solegstar/IgroSpec/(list of files, drawings)

Other design files:
pcad/Rev.A/IgroSpec.pcb
pcad/Rev.B/IgroSpec_revB.pcb
