solegstar/IgroSpec/firmware/src/profi/rtl/igrospec.vhd

-- --------------------------------------------------------------------
-- IgroSpec rev.B firmware
-- v1.0
-- (c) 2019 Andy Karpov
-- (c) 2022 Oleh Starychenko
-- --------------------------------------------------------------------

library IEEE;
use IEEE.std_logic_1164.all;
use IEEE.numeric_std.all;

entity igrospec is
	port(
		-- Clock
		CLK28				: in std_logic;
		CLK24 				: in std_logic;

		-- CPU signals
		CLK_CPU			: out std_logic := '1';
		N_RESET			: in std_logic;
		N_INT				: out std_logic := '1';
		N_RD				: in std_logic;
		N_WR				: in std_logic;
		N_IORQ_Z80		: in std_logic;
		N_MREQ			: in std_logic;
		N_M1				: in std_logic;
		A					: in std_logic_vector(15 downto 0);
		D 					: inout std_logic_vector(7 downto 0) := "ZZZZZZZZ";
		
		-- Unused CPU signals
		N_BUSREQ 		: in std_logic;
		N_BUSACK 		: in std_logic;
		N_WAIT 			: in std_logic;
		N_HALT			: in std_logic;
		N_NMI 			: out std_logic := 'Z';
		N_RFSH			: in std_logic;		

		-- RAM 
		MA 				: out std_logic_vector(18 downto 0);
		MD 				: inout std_logic_vector(7 downto 0) := "ZZZZZZZZ";
		N_MRD1			: out std_logic := '1';
		N_MWR1			: out std_logic := '1';
		N_MRD2			: out std_logic := '1';
		N_MWR2			: out std_logic := '1';
		
		-- VRAM 
		VA 				: out std_logic_vector(14 downto 0) := "000000000000000";
		VD 				: inout std_logic_vector(7 downto 0) := "ZZZZZZZZ";
		N_VRAMWR			: out std_logic := '1';

		-- ROM
		N_ROMCS			: out std_logic := '1';
		N_ROMWR			: out std_logic := '1';
		ROM_A				: out std_logic_vector (18 downto 14);
		
		-- ZX BUS signals
		BUS_N_IORQGE 	: in std_logic := '0';
		BUS_N_ROMCS 	: out std_logic := '1';
		CLK_ZXBUS		: out std_logic := '1';
		BUS_N_RDR	 	: in std_logic := '1';
		BUS_RS 			: in std_logic := '0';
		BUS_BLK		 	: in std_logic := '0';
		BUS_N_DOS	 	: out std_logic := '1';
		BUS_F			 	: out std_logic := '0';
		BUS_N_IODOS	 	: out std_logic := '1';

		-- Video
		VIDEO_CSYNC    : out std_logic;
		VIDEO_R       	: out std_logic_vector(2 downto 0) := "000";
		VIDEO_G       	: out std_logic_vector(2 downto 0) := "000";
		VIDEO_B       	: out std_logic_vector(2 downto 0) := "000";

		-- Interfaces 
		TAPE_IN 			: in std_logic;
		TAPE_OUT			: out std_logic := '1';
		BEEPER			: out std_logic := '1';

		-- AY
		CLK_AY			: out std_logic;
		AY_BC1			: out std_logic;
		AY_BDIR			: out std_logic;

		-- SD card
		SD_CLK 			: out std_logic := '0';
		SD_DI 			: out std_logic;
		SD_DO 			: in std_logic;
		SD_N_CS 			: out std_logic := '1';
		CF_N_CS 			: out std_logic := '1';
		
		-- Keyboard
		KB					: in std_logic_vector(4 downto 0) := "11111";
		-- TODO: extra signals KB 7 downto 5
		
		-- Other in signals
		TURBO_BTN		: in std_logic := '0';
		SPECIAL			: in std_logic := '0';
		IO8 				: in std_logic := '0';		
		IO11 				: in std_logic := '0';		
		IO12 				: in std_logic := '0';		
		IO15 				: in std_logic := '0';
		IO16 				: in std_logic := '0';		
		IO19 				: in std_logic := '0';
		IO21				: in std_logic := '0';				
		IO24 				: in std_logic := '0';		
		IO26 				: in std_logic := '0';
		IO27 				: in std_logic := '0';
		IO64 				: in std_logic := '0';
		IOCLR				: in std_logic := '0';
		IOE				: in std_logic;
		MAPCOND 			: out std_logic;
		NMI_BTN			: in std_logic := '1'

	);
end igrospec;

architecture rtl of igrospec is


	signal CLK 			: std_logic := '0';
	
	signal N_IORQ		: std_logic := '1';		
	
	signal clk_div2 	: std_logic := '0';
	signal clk_div4 	: std_logic := '0';
	signal clk_div8 	: std_logic := '0';
	signal clk_div16	: std_logic := '0';
	
	signal clkcpu 		: std_logic := '1';	

	signal attr_r   	: std_logic_vector(7 downto 0);
	signal vid_a 		: std_logic_vector(13 downto 0);
	signal pFF_CS		: std_logic := '0';

	signal cs_fe 		: std_logic := '0';
	signal border_attr: std_logic_vector(7 downto 0) := x"00";
	signal pal_attr	: std_logic_vector(7 downto 0) := x"00";
	signal cs_7e 		: std_logic := '0';
	signal GX0	 		: std_logic := '1';

	signal port_7ffd	: std_logic_vector(7 downto 0) := (others => '0'); 
	-- CMR0 port:
	-- D0-D2 - RAM seg A0,A1,A2 (column access)
	-- D3 - POLEK. Video page.
						-- 80DS=0: 0 - seg 05, 1 - seg 07 
						-- 80DS=1: 0 - pixels seg 04, attributes seg 38
						--         1 - pixels seg 06, attributes seg 3A
	-- D4 - ROM14. 
						-- CPM=0: 0 - spectrum 128, 1 - spectrum 48
						-- CPM=1: Ext device modifier for CP/M mode
	-- D5 - BLOCK. Block port CMR0 (WOROM=0)
	-- D6,D7 - unused
	signal rom14 		: std_logic := '0';	
																	  
	signal port_dffd 	: std_logic_vector(7 downto 0) := (others => '0');
	-- CMR1 port:
	-- D0-D2 - RAM seg A3,A4,A5 (row access)
	-- D3 - SCO. Window position for segments:
						-- 0 - window 1 (#C000 - #FFFF)
						-- 1 - window 2 (#4000 - #7FFF)
	-- D4 - WOROM. 1 = disable CMR0 port lock, also disable ROM and switch RAM seg 00 instead of it
	-- D5 - CPM. 1  = block controller from TR-DOS ROM and enables ports to access from RAM (ROM14=0)
						-- also when ROM14=1 - mod. access to extended devices in CP/M mode
	-- D6 - SCR. CPU memory instead of seg 02, also CMR0 D3 must be 1 (#8000 - #BFFF)
	-- D7 - 80DS. 0 - Spectrum video mode (seg 05)
				  -- 1 - Profi video mode (seg 06, 3A, 04, 38)
																	  
	signal ram_ext 	: std_logic_vector(2 downto 0) := "000";
	signal ram_do 		: std_logic_vector(7 downto 0);
	signal ram_oe_n 	: std_logic := '1';
	
	signal rom_oe_n 	: std_logic := '1';
	
	signal mem_adr 	: std_logic_vector(19 downto 0);
	
	signal N_MRD 		: std_logic;
	signal N_MWR 		: std_logic;
	
	signal fd_port 	: std_logic := '1';
	signal fd_sel 		: std_logic;
	
	signal turbo_mode	: std_logic;
	
	-- Port selectors
	signal selector	: std_logic_vector(3 downto 0);
	signal cs_7ffd 	: std_logic := '0';
	signal cs_1ffd 	: std_logic := '0';
	signal cs_dffd 	: std_logic := '0';
	signal cs_fffd 	: std_logic := '0';
																	  
	signal ay_port		: std_logic := '0';
	signal bdir 		: std_logic;
	signal bc1 			: std_logic;
		
	signal vbus_mode  : std_logic := '0';
	
	signal sound_out 	: std_logic := '0';
	signal mic 			: std_logic := '0';
	
	signal zc_do_bus	: std_logic_vector(7 downto 0);
	signal zc_wr 		: std_logic :='0';
	signal zc_rd		: std_logic :='0';
	signal zc_sd_cs_n	: std_logic;
	signal zc_sd_di	: std_logic;
	signal zc_sd_clk	: std_logic;
	
	signal vid_rd 		: std_logic;
	
	signal trdos		: std_logic :='1';
	signal IORQGE_ROM	: std_logic :='1';
	
	-- UART 
	signal uart_oe_n		: std_logic := '1';
	signal uart_do_bus	: std_logic_vector(7 downto 0);
	
	-- profi special signals
	signal cpm 			: std_logic := '0';
	signal worom 		: std_logic := '0';
	signal ds80 		: std_logic := '0';
	signal scr 			: std_logic := '0';
	signal sco 			: std_logic := '0';
	signal onoff 		: std_logic := '1'; -- disable CMR1 (port_dffd)	

begin

	 -- main clock selector
	 U0: entity work.clk_mux
	 port map(
		data0 => CLK28,
		data1 => CLK24,
		sel => ds80,
		result => CLK
	 );

	-- memory manager
	U1: entity work.memory 
	port map ( 
		CLK2X => CLK,
		CLKX => clk_div2,
		CLK_CPU => clkcpu,
		--TURBO => turbo,
		BUS_N_ROMCS => BUS_N_RDR,
		
		-- cpu signals
		A => A,
		D => D,
		N_MREQ => N_MREQ,
		N_IORQ => N_IORQ,
		N_WR => N_WR,
		N_RD => N_RD,
		N_M1 => N_M1,

		-- ram 
		MA => mem_adr,
		MD => MD,
		N_MRD => N_MRD,
		N_MWR => N_MWR,
		
		-- ram out to cpu
		DO => ram_do,
		N_OE => ram_oe_n,
		
		-- ram pages
		RAM_BANK => port_7ffd(2 downto 0),
		RAM_EXT => ram_ext, -- seg A3 - seg A5

		-- video
		VA => vid_a,
		VID_PAGE => port_7ffd(3), -- seg A0 - seg A2
		DS80 => ds80,
		CPM => cpm,
		SCO => sco,
		SCR => scr,
		WOROM => worom,

		-- video bus control signals
		VBUS_MODE_O => vbus_mode, -- video bus mode: 0 - ram, 1 - vram
		VID_RD_O => vid_rd -- read attribute or pixel	
	);
		
	-- Z-Controller
	U2: entity work.zcontroller 
	port map(
		RESET => not(N_RESET),
		CLK => clk_div4,
		A => A(5),
		DI => D,
		DO => zc_do_bus,
		RD => zc_rd,
		WR => zc_wr,
		SDDET => '0',
		SDPROT => '0',
		CS_n => zc_sd_cs_n,
		SCLK => zc_sd_clk,
		MOSI => zc_sd_di,
		MISO => SD_DO
	);
	
-- video controller
	U3: entity work.video 
	port map (
		CLK => clk_div2, -- 14
		CLK2x => CLK, -- 28
		ENA => clk_div4, -- 7
		
		N_RESET => N_RESET,
		
		BORDER => border_attr,
		PAL_ADR => pal_attr,
		DI => MD,
		TURBO => turbo_mode,
		INTA => N_IORQ or N_M1,
		INT => N_INT,
		ATTR_O => attr_r, 
		A => vid_a,
		pFF_CS => pFF_CS,
		
		DS80 => ds80,
		
		CS7E => cs_7e,
		BUS_A => A (15 downto 8),
		BUS_WR_N => N_WR,
		GX0 => GX0,
		
		VA => VA,
		VD => VD,
		N_VRAMWR => N_VRAMWR,
		
		VIDEO_R => VIDEO_R,
		VIDEO_G => VIDEO_G,
		VIDEO_B => VIDEO_B,
		
		HSYNC => open,
		VSYNC => open,
		CSYNC => VIDEO_CSYNC,

		VBUS_MODE => vbus_mode,
		VID_RD => vid_rd
	);
	
	U4: entity work.ROM
	port map (
		CLK				=> CLK,
		ADR				=> A(15 downto 0),
		DATA				=> D(7 downto 0),
		nRESET			=> N_RESET,
		nWR				=> N_WR,
		nRD				=> N_RD,
		nIORQ				=> N_IORQ_Z80,
		nMREQ				=> N_MREQ,
		nDOS				=> trdos,
		ROM14				=> rom14,
		nROM_EN			=> worom,
		rom_a(18 downto 14)	=> ROM_A(18 downto 14),
		rom_we			=> N_ROMWR,
		rom_oe			=> rom_oe_n,
		IORQGE_ROM		=> IORQGE_ROM
	);
	
	-- clocks
	process (CLK)
	begin 
		if (CLK'event and CLK = '1') then 
			clk_div2 <= not(clk_div2);
		end if;
	end process;
	
	process (clk_div2)
	begin 
		if (clk_div2'event and clk_div2 = '1') then 
			clk_div4 <= not(clk_div4);
		end if;
	end process;
	
	process (clk_div4)
	begin 
		if (clk_div4'event and clk_div4 = '1') then 
			clk_div8 <= not(clk_div8);
		end if;
	end process;

	process (clk_div8)
	begin 
		if (clk_div8'event and clk_div8 = '1') then 
			clk_div16 <= not(clk_div16);
		end if;
	end process;
	
	-- Sync Z80 with CLK
	process (CLK)
	begin
		if CLK'event and CLK = '1' then
			N_IORQ <= N_IORQ_Z80 or BUS_N_IORQGE;
			turbo_mode <= not TURBO_BTN;
		end if;
	end process;

	-- ROM
	N_ROMCS <= rom_oe_n;

	--RAM
	MA <= mem_adr(18 downto 0);
	
	N_MRD1 <= '0' when N_MRD = '0' and mem_adr(19) = '0' else '1';  
	N_MWR1 <= '0' when N_MWR = '0' and mem_adr(19) = '0' else '1';  
	N_MRD2 <= '0' when N_MRD = '0' and mem_adr(19) = '1' else '1';  
	N_MWR2 <= '0' when N_MWR = '0' and mem_adr(19) = '1' else '1';
	
	-- #FD port correction
	-- IN A, (#FD) - read a value from a hardware port 
	-- OUT (#FD), A - writes the value of the second operand into the port given by the first operand.
	 fd_sel <= '0' when D(7 downto 4) = "1101" and D(2 downto 0) = "011" else '1'; -- IN, OUT Z80 Command Latch

	 process(fd_sel, N_M1, N_RESET)
	 begin
			if N_RESET='0' then
				  fd_port <= 	'1';
			elsif rising_edge(N_M1) then 
				  fd_port <= fd_sel;
			end if;
	 end process;

	-- CPU clk selector

	process (CLK, clk_div2, clk_div4, clk_div8, clkcpu)
	begin
		if CLK'event and CLK = '1' then
			if clk_div2 = '1' and turbo_mode = '0' then
				clkcpu <= clk_div4;
			elsif clk_div2 = '0' and clk_div4 = '1' and turbo_mode = '1' then
				clkcpu <= clk_div8;
			end if;
		end if;
	end process;

--clkcpu <= clk_div8;

	--ZX-BUS Signals
	BUS_F <= clk_div2;
	BUS_N_IODOS <= not cpm;
	BUS_N_DOS <= trdos;
	BUS_N_ROMCS <= rom_oe_n;
	CLK_CPU <= clkcpu;
	CLK_ZXBUS <= clk_div2;
	CLK_AY	<= clk_div16;

	-- CF Card
	CF_N_CS <= '0' when A(5 downto 3) = "101" and A(1 downto 0) = "11" and N_IORQ = '0' and N_M1 = '1' and BUS_N_IORQGE = '0' else '1';

	-- SD card
	-- z-controller 
	zc_wr <= '1' when (N_IORQ = '0' and N_M1 = '1' and N_WR = '0' and A(7 downto 6) = "01" and A(4 downto 0) = "10111") else '0';
	zc_rd <= '1' when (N_IORQ = '0' and N_M1 = '1' and N_RD = '0' and A(7 downto 6) = "01" and A(4 downto 0) = "10111") else '0';
	SD_N_CS <= zc_sd_cs_n;
	SD_CLK <= zc_sd_clk;
	SD_DI <= zc_sd_di;

	-- AY signals
	AY_BDIR	<= '1' when (N_M1 = '1' and N_IORQ = '0' and N_WR = '0' and A(15) = '1' and A(1) = '0') and BUS_N_IORQGE = '0' else '0';
	AY_BC1	<= '1' when (N_M1 = '1' and N_IORQ = '0' and A(15) = '1' and A(14) = '1' and A(1) = '0') and BUS_N_IORQGE = '0' else '0';
	
	-- Tape Out bit
	TAPE_OUT <= border_attr(3);
	-- beeper
	BEEPER <= border_attr(4);
	
	-- NMI button
	N_NMI <= NMI_BTN;
	
	-- Mapcond LED control
--	MAPCOND <= '1';
	MAPCOND <= not zc_sd_cs_n;

	rom14 <= port_7ffd(4); -- rom bank
	cpm <= port_dffd(5); -- 1 - блокирует работу контроллера из ПЗУ TR-DOS и включает порты на доступ из ОЗУ (ROM14=0); При ROM14=1 - мод. доступ к расширен. периферии
	worom <= port_dffd(4); -- 1 - отключает блокировку порта 7ffd и выключает ПЗУ, помещая на его место ОЗУ из seg 00
	ds80 <= port_dffd(7); -- 0 = seg05 spectrum bitmap, 1 = profi bitmap seg06 & seg 3a & seg 04 & seg 38
	scr <= port_dffd(6); -- памяти CPU на место seg 02, при этом бит D3 CMR0 должен быть в 1 (#8000-#BFFF)
	sco <= port_dffd(3); -- Выбор положения окна проецирования сегментов:
								-- 0 - окно номер 1 (#C000-#FFFF)
								-- 1 - окно номер 2 (#4000-#7FFF)
	
	ram_ext <= port_dffd(2 downto 0);
	
	cs_fe <= '1' when N_IORQ = '0' and A(0) = '0' else '0';
	cs_dffd <= '1' when N_IORQ = '0' and N_M1 = '1' and A = X"DFFD" and fd_port = '1' else '0';
	cs_7ffd <= '1' when N_IORQ = '0' and N_M1 = '1' and A(15) = '0' and A(1) = '0' else '0';
	
	-- ports, write by CPU
	process( CLK, N_RESET, A, D, port_7ffd, N_M1, N_MREQ )
	begin
		if N_RESET = '0' then
			port_dffd <= (others => '0');
			port_7ffd <= (others => '0');
			trdos <= '0'; -- 1 - boot into service rom, 0 - boot into 128 menu
		elsif CLK'event and CLK = '1' then 

				-- port #DFFD (profi ram ext)
				if cs_dffd = '1' and N_WR = '0' then
					port_dffd <= D;
				end if;
				
				-- port #7FFD 
				if cs_7ffd = '1' and N_WR = '0' and IORQGE_ROM = '0' and (port_7ffd(5) = '0' or port_dffd(4)='1') then -- short decoding #FD
					port_7ffd <= D;
				end if;

				-- port #FE
				if cs_fe = '1' and N_WR = '0' then
					border_attr <= D; -- border attr
				end if;

				-- trdos flag
				if N_M1 = '0' and N_MREQ = '0' and A(15 downto 8) = X"3D" and rom14 = '1' then 
					trdos <= '0';
				elsif ((N_M1 = '0' and N_MREQ = '0' and A(15 downto 14) /= "00")) then 
					trdos <= '1'; 
				end if;
				
		end if;
	end process;
	
	-- порты #7e - пишутся по фронту /wr
	pal_attr <= D when cs_fe = '1' and (N_WR'event and N_WR = '1');
	cs_7e <= '1' when cs_fe = '1' and A(7) = '0' else '0';
	
	-- read ports by CPU
process (selector, ram_do, port_dffd, port_7ffd, zc_do_bus, GX0, TAPE_IN, KB, attr_r)
	begin
		case selector is
			when x"0" => D <= ram_do; 		-- #memory
			when x"1" => D <= port_dffd;	-- #DFFD read
			when x"2" => D <= port_7ffd;	-- #7FFD read
			when x"3" => D <= zc_do_bus;	-- Z-controller
			when x"4" => D <= GX0 & TAPE_IN & '1' & KB(4 downto 0);	-- #FE - keyboard
			when x"5" => D <= attr_r;		-- #FF - attributes
			when others => D <= "ZZZZZZZZ";
		end case;
	end process;

selector <=
	x"0" when ram_oe_n = '0' else -- #memory
	x"1" when cs_dffd = '1' and N_RD = '0' and BUS_N_IORQGE = '0' else -- #DFFD read
	x"2" when cs_7ffd = '1' and A = X"7FFD" and N_RD = '0' and BUS_N_IORQGE = '0' else  -- #7FFD read
	x"3" when zc_rd = '1' and BUS_N_IORQGE = '0' else -- Z-controller
	x"4" when cs_fe = '1' and N_RD = '0' and BUS_N_IORQGE = '0' else -- #FE - keyboard
	x"5" when pFF_CS = '0' and N_IORQ = '0' and N_RD = '0' and A(7 downto 0) = x"FF" and trdos = '1' and cpm = '0' and DS80 = '0' and BUS_N_IORQGE = '0' else -- #FF - attributes (timex port never set)
	(others => '1');

end;
