solegstar/IgroSpec/(commit log)

2021-06-06 Added "CF BUSY" LED and KX generator
    [IgroSpec.SCH, IgroSpec_revB.pcb]
2021-06-06 Corrected BOM and album
    [IgroSpec_BOM.xls, IgroSpec_revB.pcb]
2021-06-17 Added mounting pads for middle-size CF-card slot
    [IgroSpec_revB.pcb]
2021-09-09 Added Interactive BOM for Rev.B
    [IgroSpec_revB.pcb]
2021-09-10 fixed size of PCB, gerbers and album
    [IgroSpec_revB.pcb]
2021-09-14 fixed crystal resonator position
    [IgroSpec_revB.pcb]
2022-01-19 added pull-up resistors to sd-card
    [IgroSpec.SCH, IgroSpec_revB.pcb]
2022-01-19 fix silk layer
    [IgroSpec_revB.pcb]
2022-01-22 added roms and some fixes at CF init
    [igrospec.vhd]
2022-02-03 added some fixes to sd card
    [IgroSpec_revB.pcb]
2025-05-16 some fixes of signals
    [igrospec.vhd]
2025-05-22 Profi screen position fixed
    [video.vhd]
